mhughes30/LED_Headlight/20151107_143428.jpg

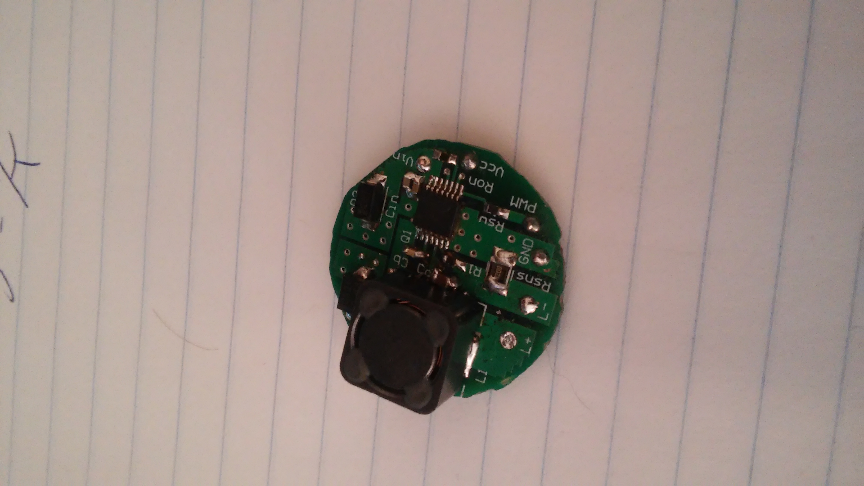
20151107_143428.jpg
