mhughes30/LED_Headlight/20151107_152742.jpg

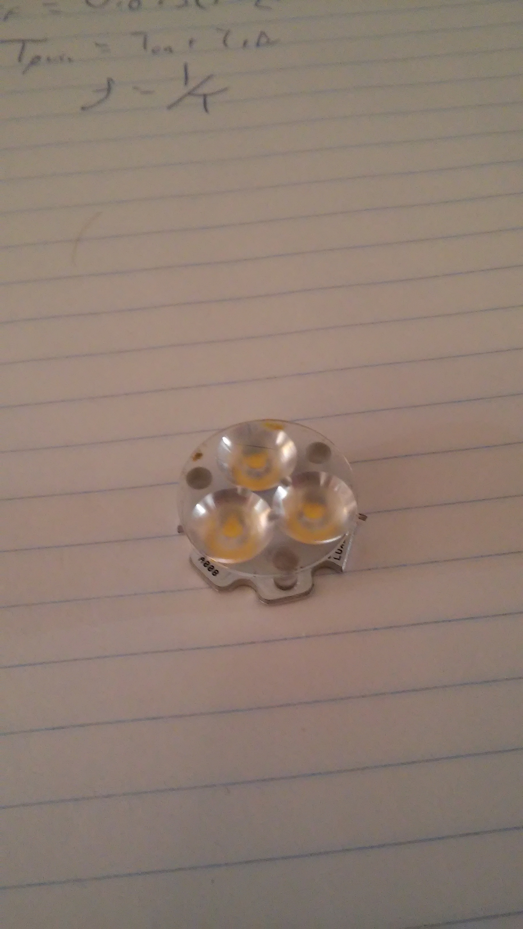
20151107_152742.jpg
