mhughes30/LED_Headlight/README.md

# LED_Headlight 

This contains a large number of files for building your own LED bicycle headlight (or stroller headlight - I've used it for that too). 

To get details on the files and light, please visit www.mikehughesguitar.com.
