mhughes30/LED_Headlight/555_PWM_layout.png

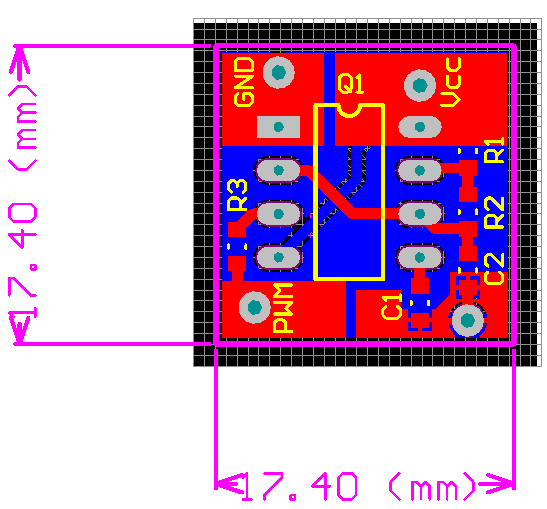
555_PWM_layout.png
