mhughes30/LED_Headlight/20151107_143455.jpg

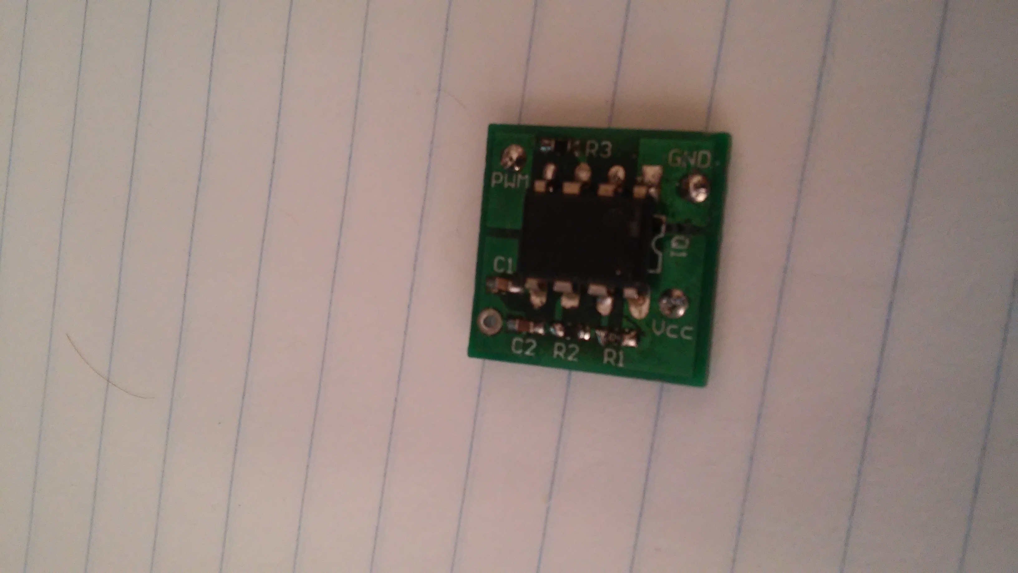
20151107_143455.jpg
