mhughes30/LED_Headlight/designExample1.png

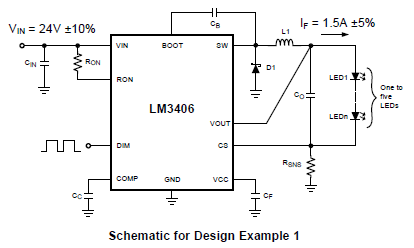
designExample1.png
