mhughes30/LED_Headlight/headlight.png

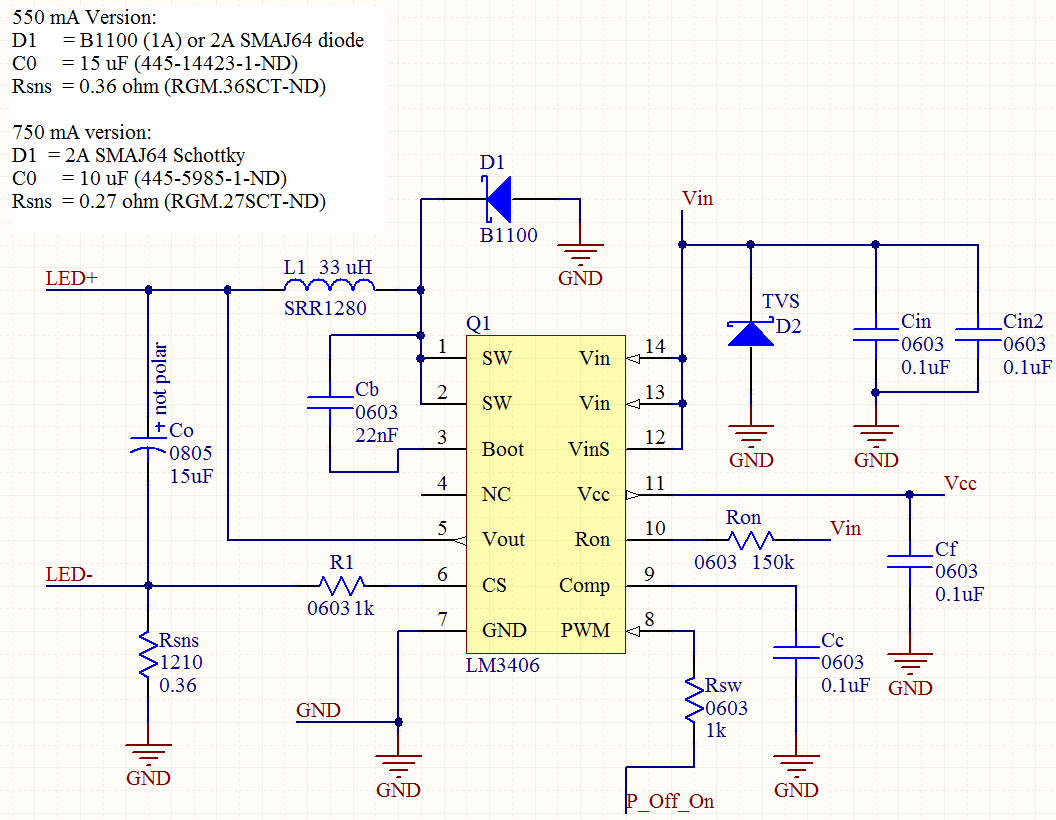
headlight.png
