mhughes30/LED_Headlight/ledPCB_bot.png

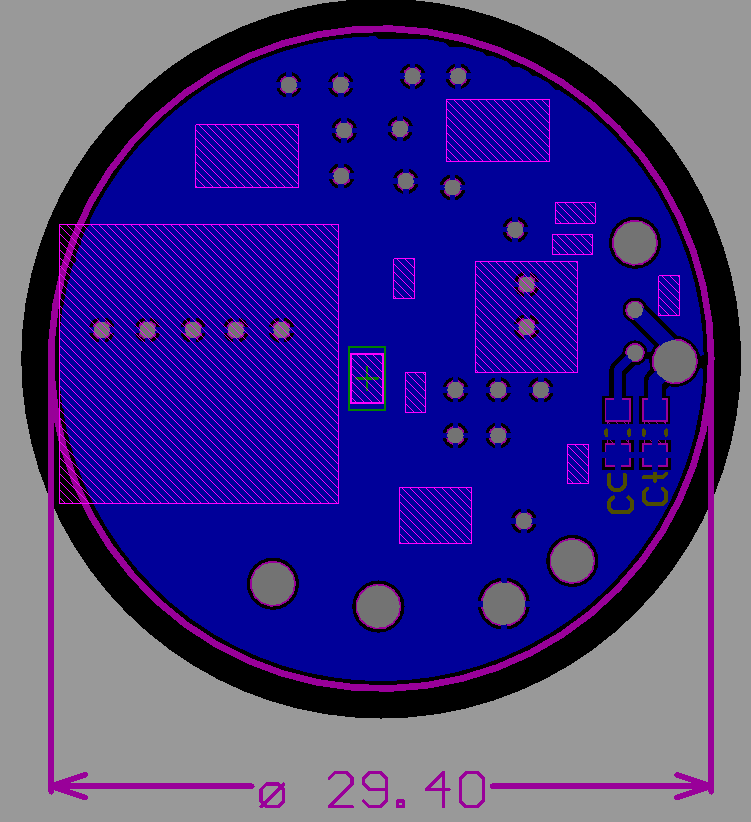
ledPCB_bot.png
