mhughes30/LED_Headlight/ledPCB_top.png

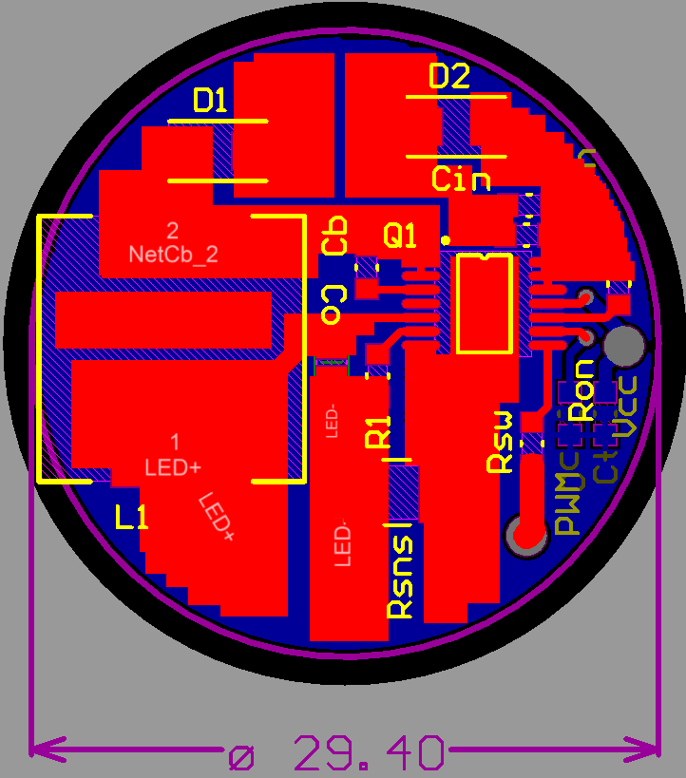
ledPCB_top.png
