mhughes30/LED_Headlight/pwm.jpg

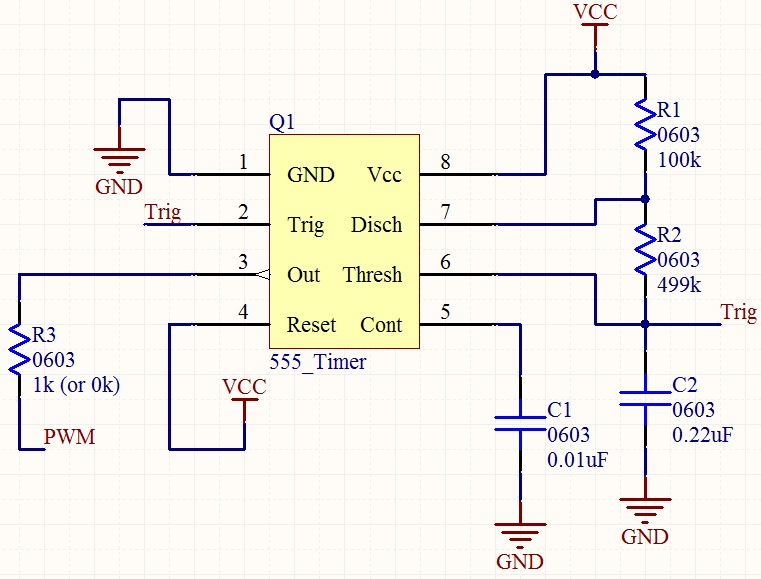
pwm.jpg
