mhughes30/LED_Headlight/Headlight.ods

Sheet: Sheet1
LT1956 |  |  |  | Cree LED
 |  |  | mA | Vf_I | Vf x 3 | Watts
Feedback Resistors |  |  | 350 | 2.8 | 8.4 | 2.94
Vout | 9 | V | 400 | 2.875 | 8.625 | 3.45
R2 | 4990 | ohm | 500 | 2.93 | 8.79 | 4.395
R1 | 31821.4754098361 | ohm | 600 | 3 | 9 | 5.4

Sheet: LM3406HV
Type | Variable | Value | Description/Units | more units
independent | Vd | 0.65 | schottky
independent | Vin | 52.00 | V
independent | Vo | 10.00 | V
 | Rdson | 0.75 | ohm |  |  |  | Amps Spec: | 0.55 | 0.74 | 1 | 1.1 | 1.25 | 1.5
independent | If | 1 | A |  |  |  | Rsns | 0.36 | 0.27 | 0.2 | 0.182 | 0.16 | 0.133
 | Vsw | 0.75 | V |  |  |  | CoMin (uF) | 14 | 10 | 7 | 6.2 | 5.23 | 4.1
 | D | 0.205 | duty cycle |  |  |  | CinMin (uF) | 0.12 | 0.16 | 0.23 | 0.25 | 0.27 | 0.35
 | Rsns | 0.200 | ohm |  |  |  | Watts | 5.5 | 7.4 | 10 | 10.12 | 11.5 | 13.8
 | Psns | 0.200 | W |  |  |  | warm white lumens | 450 | 570 | 705 | 780 | 855 | 975
 | Vsns | 0.200 | V |  |  |  | cold white lumens | 585 | 741 | 916 | 1014 | 1112 | 1268
 | Vled | 9.800 | V |  |  |  | warm white lumens/Watt | 82 | 77 | 71 | 77 | 74 | 71
 | Id | 0.79 | A |  |  |  | cold white lumens/Watt | 106 | 100 | 92 | 100 | 97 | 92
 | Pd | 0.52 | W |  |  |  | max input current (A) (38.4) | 0.14 | 0.19 | 0.26 | 0.26 | 0.30 | 0.36 | 38.4
independent | Ron | 150,000.00 | 150 | kOhm |  |  | max input current (A) (12) | 0.46 | 0.62 | 0.83 | 0.84 | 0.96 | 1.15 | 12
 | ton | 4.88805940594059E-007 | 488.81 | ns |  |  | max input current (A) (52) | 0.11 | 0.14 | 0.19 | 0.19 | 0.22 | 0.27 | 52
 | fsw | 419803.228842392 | 419.80 | kHz
independent | L Ripple | 0.4 | pp |  |  |  |  | Amps | 0.35 | 0.7 | 0.55 | 0.74 | 1 | 1.1 | 1.25 | 1.5
 | dIL | 0.6 | A |  |  |  |  | % lumens | 100.00% | 175.00% | 150.00% | 190.00% | 235.00% | 260.00% | 285.00% | 325.00%
 | Lmin | 3.42164158415841E-005 | 34.22 | uH |  | cold white | CREE XTE-W390 | lumens | 390 | 693 | 585 | 741 | 917 | 1014 | 1112 | 1268
independent | IL | 1.5 | A |  |  | neutral white | Luxeon Rebel – 07007-PW740-N | lumens | 315 | 567 | 473 | 599 | 740 | 819 | 898 | 1024
 | Ilpeak | 1.7 | A |  |  | warm white | CREEXTE-WW300 | lumens | 320 | 534 | 480 | 608 | 752 | 832 | 912 | 1040
 | rD | 0.25 | ohms
independent | Ifr | 0.11 | ripple current %
 | dIf | 0.11 | A
 | Zc | 0.056122449 | ohms
 | Co | 6.75519271515286E-006 | 6.76 | uF | X7R | > 25 V rating
0.04 | dVin | 2.08 | V
 | CinMin | 0.000000235 | 0.2350028561 | uF | X7R | > 100 V rating
 | CB | 22 |  | nF | X7R | > 25 V rating
 | CF | 100 |  | nF | X7R | > 25 V rating |  |  |  | 0.27 | 0.135
 | CC | 100 |  | nF | X7R | > 25 V rating |  |  |  | 0.27
 | Power | Value | Units
Po | output | 10 | W
Pc | conduction loss | 0.1539 | W
Pg | gate driver | 0.2277 | W
Ps | switch loss | 0.4366 | W
independent | inductor DCR | 0.0560 | ohms
PL | inductor loss | 0.056 | W
Psns | current Rsns | 0.2 | W
 | Efficiency | 90.30%
 | Trise | 40.91 | degrees C
 | Power when Off | Ioff | 0.000 | A
 |  | Poff | 18.027 | mW

Sheet: 555_Timer
 | 1 Time Constant Factor: | 0.693
 | Flashing Circuit
 |  | Fast Cycle | Slower cycle
 | R1 (ohms) | 100000 | 100000
 | R2 (ohms) | 499000 | 499000
 | C1 (uF) | 4.7 | 0.22
On Period | T1 (s) | 1.95 | 0.09
Off Period | T2 (s) | 1.63 | 0.08
 | T (s) | 3.5762958 | 0.16740108
 | F (Hz) | 0.28 | 5.97
 | Duty Cycle | 45.45% | 45.45%

Sheet: Parts
 | 1000 mA version |  |  |  |  |  |  | # of Boards Desired: | 6
 | LM3405 LED Driver |  |  |  |  |  |  | # Spare | 1
 | Name | Type | Value | Package | Description | # per Board | Cost per Unit | Digikey Part | Current Inventory | # of Needed | On Order | # to Order | Cost per Board
 | Co | cap | > 7 uF | 0805 | >25V, X5R | 1 | $0.69 | 445-14423-1-ND | 3 | 7 | 3 | 1 | $0.69
 | R1, Rsw | res | 1k | 0603 | 1/10w | 2 | $0.01 | 311-1.0KGRCT-ND | 48 | 13 |  | 0 | $0.02
 | Cc, Cf, Cin | cap | 0.1 uF | 603 | 100 V, x7R | 3 | $0.14 | 490-3285-1-ND | 2 | 19 | 50 | 0 | $0.41
 | Ron | res | 150k | 603 | 1/10w | 1 | $0.02 | 311-150KHRCT-ND | 23 | 7 | 10 | 0 | $0.02
 | Cb | cap | 22 nF | 603 | 25 V, x7R | 1 | $0.04 | 1276-2000-1-ND | 8 | 7 | 25 | 0 | $0.04
 | D2 | TVS | 64vwm | SMAJ64 |  | 1 | $0.36 | SMAJ64ALFCT-ND | 8 | 7 | 2 | 0 | $0.36
 | Rsns | res | 0.2 | 1210 | ½ W | 1 | $0.25 | RHM.36SCT-ND | 0 | 7 | 25 | 0 | $0.33
 | D1 | diode | 2A | SMAJ64 | schottky, 2A, 60V | 1 | $0.59 | CMSH2-60 | 8 | 7 | 3 | 0 | $0.59
 | Q1 | LED driver | 75V | 14TSSOP | LM3406HV | 1 | $2.59 | LM3406HVMHX | 1 | 7 | 6 | 0 | $2.59
 | L1 | ind | 33 uH | SMA | 3.5A | 1 | $0.93 | SRR1280-330MCT-ND (http://www.digikey.com/product-detail/en/SRR1280-330M/SRR1280-330MCT-ND/2127440) | 3 | 7 | 20 | 0 | $0.93
 | PCB |  |  |  |  | 1 | $10.00 |  | 1 | 7 | 6 | 0 | $10.00
 | Total Cost: | $15.96
Purpose | Optional Components | Trade | Stock | Part
550 mA version | D1 | Use B1100 | 4
550 mA version | Rsns | 0.36 | 8 | RHM.36SCT-ND
550 mA version | Co | 15 uF |  | 445-14423-1-ND | 35 V, x5R, 0805
750 mA version | Rsns | 0.27 | 0 | RHM.27SCT-ND |  |  |  | Type | Total Cost | No Battery | Watts | Run time (h) | Wh | Volts | mAh
750 mA version | Co | 10uF | 14 | 445-5985-1-ND | 25 V, x5R, 0805 |  |  | Headlight on/off | $46.47 |  | 9.2 | 3.2 | 29.44 | 14.8 | 1989
1000 mA version | Rsns | 0.2 | 25 |  |  |  |  | Headlight on/off/flash | $52.11
 |  |  |  |  |  |  |  | battery/charger | $31.83
 |  |  |  |  |  |  |  | Total 1: | $78.30 | headlight/battery
Goal | Headlight Components | Cost per Item | Source |  |  |  |  | Total 2: | $83.94 | headlight/flash/battery
Make Myself | Housing | $6.00 | Hoffman |  |  |  |  | Total 3: | $46.47
Make Myself | heatsink | $6.50 | Hoffman |  |  |  |  |  |  | Profit:
 | 34.8 mm glass | $0.75 | Hoffman |  |  |  |  | Sell 1: | $114.00 | $35.70
3D print | Fork Mount | $5.00 |  |  |  |  |  | Sell 2: | $120.00 | $36.06
 | New Style Hbar mount | $9.00 | Hoffman |  |  |  |  | Sell 3: | $97.00 | $50.53
 | Old Style Hbar mount | $1.50 | Hoffman
 | SPST Switch | $0.61 | Digikey | CW183-ND
est | Wire 2 conductor | $1.00 |  | 1.5 feet
est | DC connector | $1.00
 | Complete Housing Cost | $24.86 | New Style Hbar mount
 |  | $17.36 | Old Style Hbar mount
 |  | $29.86 | Org Fork mount and Hbar mount
 |  | $20.86 | New Style fork mount
 | Flashing PWM Circuit
 | Name | Type | Value | Package | Description | # per Board | Cost per Unit | Digikey Part | Current Inventory | # of Needed | On Order | # to Order | Cost per Board
 | Q1 | 555 Timer |  | 8-PDIP | 100 kHz | 1 | $0.38 | 296-1411-5-ND | 10 | 7 |  | 0 | $0.38
 | C1 | cap | 0.01 uF | 0603 | 16V, 10% | 1 | $0.17 | 399-7841-1-ND | 10 | 7 |  | 0 | $0.17
 | C2 | cap | 0.22 uF | 0603 | 16V, 10% | 1 | $0.07 | 445-1318-1-ND | 20 | 7 |  | 0 | $0.07
 | R1 | res | 100k | 0603 |  | 1 | $0.01 | 311-100KGRCT-ND | 25 | 7 |  | 0 | $0.01
 | R2 | res | 499k | 0603 |  | 1 | $0.02 | 311-499KHRCT-ND | 25 | 7 |  | 0 | $0.02
 | PCB |  |  |  |  | 1 | $5.00 |  | 0 | 7 |  | 7 | $5.00
 | Total Cost: | $5.64 |  |  |  | 1 |  |  | 0 | 7 | 7
 | Solo Battery Pack | Cost per Item | Source | Part #
14.8 V, 4S LiIon | BMS | $6.75 | battery space | PCB-S4A5-GS
 | Fuel Gauge PCB, 14.8 | $7.95 | battery space | PCB-4GS-1
 | Trustfire, 18650, 4 | $16.42 | deal extreme | 5790
 | Boost Converter | $4.99 | deal extreme | 149681
 | Voltage Display | $4.43 | deal extreme | 163563
 | USB cable | $4.00 | deal extreme
 | Nylon Puch | $1.99 | deal extreme | 272128
 | Total 1: | $42.10
 | Total 2: | $31.83

Sheet: Battery_non_eBike
 |  |  |  |  | Run Time (hours)
 | Volts | Ah | Wh | Light Power (W) | 80.00% | 100.00%
Trustfire, 18650, 4 | 16.80 | 2.30 | 38.64 | 9.2 | 3.36 | 4.2
LED Status
1 – flashing | < 11.9 V | recharge
1 | 11.8 – 14.3
2 | 14.1 – 15
3 | 14.9 – 15.8
4 | 15.7 – 16.2
5 | > 16.1
BMS
Overcharge | 17.4
Over-discharge | 9.6
Charge Time
Vin | 5 | V
Imax | 0.9 | A
Wmax | 4.5 | W
Vout | 16.8 | V
efficiency | 0.95
Iout | 0.25 | A
Tmax | 9.04 | hours
