mhughes30/LED_Headlight/forkLightMount.stl

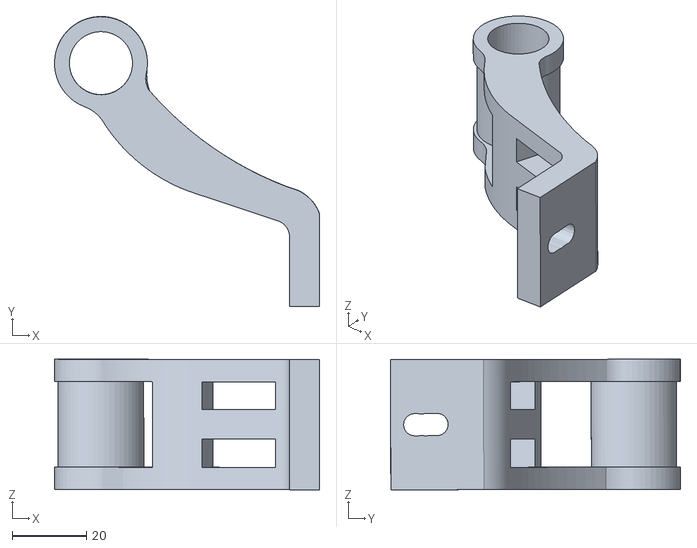
[picture p10: CAD file, 2015-11-08]
forkLightMount.stl
71.2 x 78.0 x 35.2
