mhughes30/LED_Headlight/(list of files, cad)

Other CAD files:
forkLightMount.skp
