mhughes30/LED_Headlight/(list of files, drawings)

Other design files:
Headlight_555_Flasher/PCB1.PcbDoc
Headlight_555_Flasher/PCB_Project1.PrjPCB
Headlight_555_Flasher/Sheet1.SchDoc
Headlight_eBike_LED_Driver/Headlight_eBike_LED_Driver/Led_Driver_Headlight.PrjPCB
Headlight_eBike_LED_Driver/Headlight_eBike_LED_Driver/PCB1.PcbDoc
Headlight_eBike_LED_Driver/Headlight_eBike_LED_Driver/Sheet1.SchDoc
