mhughes30/LED_Headlight/wiringDiagram.png

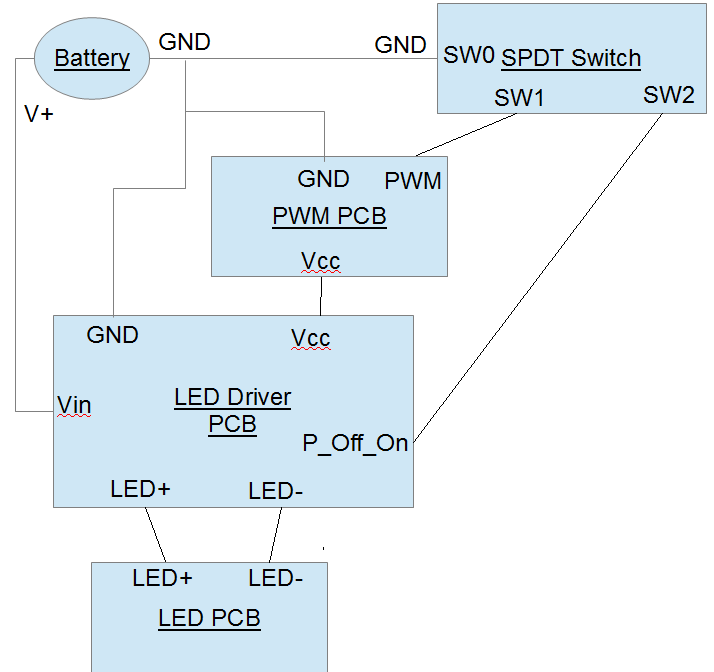
wiringDiagram.png
