mhughes30/LED_Headlight/(commit log)

2015-11-08 new commit
    [Headlight.ods, forkLightMount.skp, forkLightMount.stl]
2016-11-08 fixing issue with incomplete upload
    [Headlight.ods, Led_Driver_Headlight.PrjPCB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]
2016-11-08 removing corrupted files
    [Headlight.ods]
2016-11-08 adding uncompressed folder, and tying to readd spreadsheet
    [Headlight.ods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]
